xiaomiao321/Aiot-project-ESP32C3/img/DNS_Failed.png

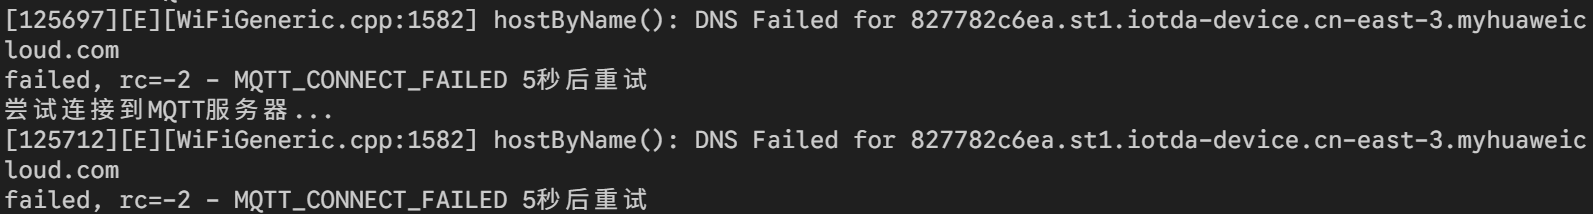
img/DNS_Failed.png
