xiaomiao321/Aiot-project-ESP32C3/img/page2.jpg

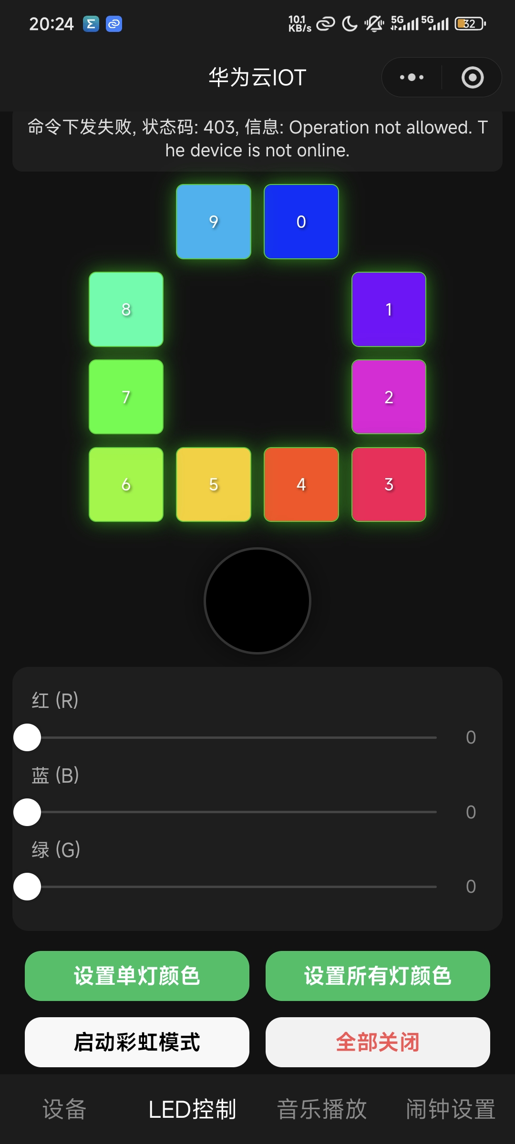
img/page2.jpg
