xiaomiao321/Aiot-project-ESP32C3/img/光敏电阻.png

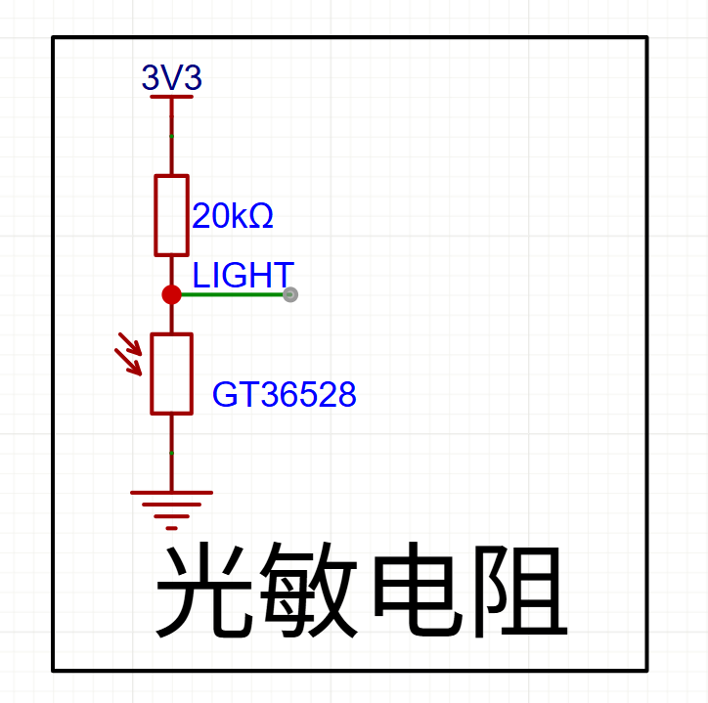
img/光敏电阻.png
