xiaomiao321/Aiot-project-ESP32C3/img/屏幕点亮.jpg

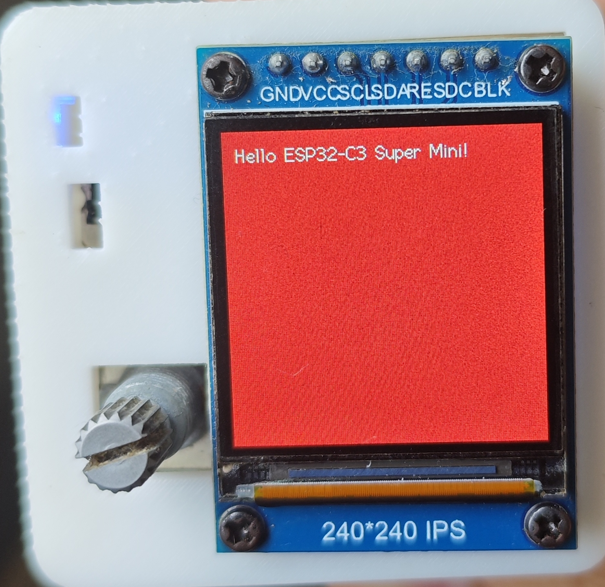
img/屏幕点亮.jpg
