xiaomiao321/Aiot-project-ESP32C3/img/框架.png

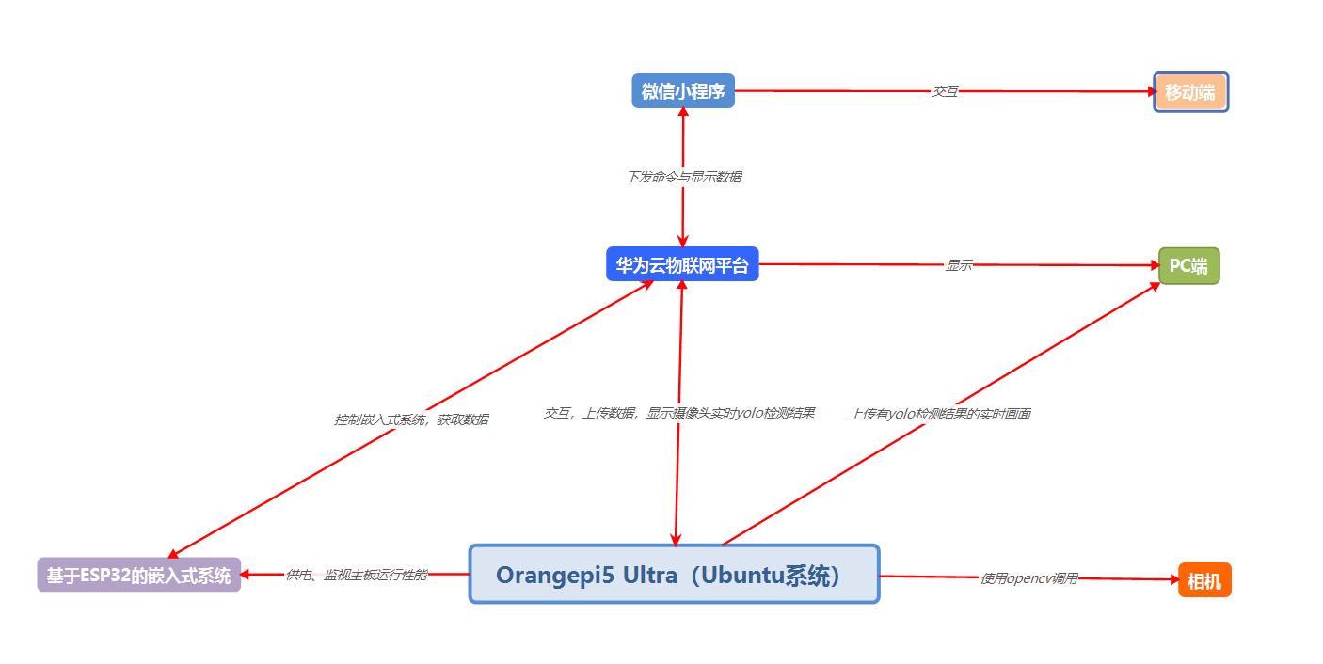
img/框架.png
