xiaomiao321/Aiot-project-ESP32C3/src/Hardware/Weather_Clk_PlatformIO/Weather_Clk/src/Watchface.h

#ifndef WATCHFACE_H
#define WATCHFACE_H

/**
 * @brief 表盘选择菜单的入口函数。
 * @details 此函数显示一个可滚动的列表，其中包含所有可用的表盘样式。
 *          用户可以使用旋转编码器进行选择，单击按钮以应用并显示所选表盘。
 *          在表盘显示界面，单击按钮可以返回到此选择菜单。
 */
void WatchfaceMenu();

#endif // WATCHFACE_H
