xiaomiao321/Aiot-project-ESP32C3/(commit log)

2025-11-08 backup before fixing PC
    [MQTT.cpp, System.cpp, performance.cpp, performance.h]
2025-11-08 doc:backup before comment of .cpp;bug:no PC Data
    [ADC.cpp, ADC.h, Alarm.cpp, Alarm.h, Buzzer.h, Countdown.h, DS18B20.h, Games.h]
2025-11-09 feat:成功移植PlatformIO;bug:修复电脑数据
    [partition.csv]
2025-11-09 feat:加入了WIFI和MQTT测试程序，实现了上报数据
2025-11-09 基本实现所以功能，包括数据上传、命令接收。不过电脑数据一直有问题，先这样吧
2025-11-10 优化目录结构，加入了初始小程序
    [partition.csv]
2025-11-10 feat:微信小程序测试成功，bug:电脑数据依旧有问题，但是测试程序没问题
    [partition.csv]
2025-11-11 bug:修复PCData数据接收;feat:小程序加入PC数据显示
2025-11-12 doc:编辑了注释
2025-11-12 doc:加入文档
2025-11-12 恢复误删除的小程序
2025-11-13 doc:优化目录结构，改进实验报告和README
    [partition.csv]
2025-11-13 final commit : 完善实验报告
